0x0c/AmbientPixel/Docs/markdown/FutureWork.md

# Future works

## パケット仕様の拡張
より高度な制御を行うために、パケットの仕様を拡張する。
以下、策定中のパケット仕様。

--

### パケットのデータ構造
#### 基本構造
BaseパケットとDataパケットに大別される。

#### Baseパケット

````
Base packet
|---3bit---|----5bit----|
|---type---|--data len--|
````

- type
	- パケットの種類
		- echo → 000
		- pattern → 001
		- data → 011
		- int → 100
		- int_cast → 101
		- run → 110
		- reset → 111
		- 記載していないビットは予約
- data len
	- データ長(バイト)
		- 1〜32バイト
		- 後続にデータ長*2個だけパケットが続く

#### Dataパケット

````
Data packet
|---3bit---|---4bit---|---1bit---|
|---type---|---data---|--parity--|
````

- type
	- 011
- data
	- データ部
- parity
	- パリティビット(奇数パリティ)

### echoパケット
**Base部**

- type
	- 000
- data len
	- 2
	
**Data部**

````
|---8bit---|
|----to----|
~
|---8bit---|
|---from---|
````

- to
	- 送信先デバイスID
		- masterへの場合は0
		- それ以外はフルビット
- from
	- 送信元デバイスID
		- masterからの場合は0
	
**解説**

echoパケットを受信したらmasterへ向けて返答する。
また、echoパケットを別ポートからフォワードする。

### patternパケット
**Base部**

- type
	- 001
- data len
	- 2〜32
	
**Data部**

````
|---8bit---|
|----to----|
~
|---8bit---|
|--pattern-|
~
...
````

**解説**

### intパケット
**Base部**

- type
	- 100
- data len
	- 0

**Data部**

なし

**解説**

intパケットを受け取ったノードはインタラクティブ状態へ遷移する。

### int_castパケット
**Base部**

- type
	- 101
- data len
	- 0

**Data部**

なし

**解説**

int_castパケットを受け取ったノードはインタラクティブ状態へ遷移する。
また、int_castパケットを別ポートからフォワードする。

### runパケット
**Base部**

- type
	- 110
- data len
	- 0

**Data部**

なし

**解説**

runパケットを受け取ったノードは実行状態へ遷移する。
また、runパケットを別ポートからフォワードする。

### resetパケット
**Base部**

- type
	- 111
- data len
	- 0

**Data部**

なし

**解説**

resetパケットを受け取ったノードは待機状態へ遷移する。
また、resetパケットを別ポートからフォワードする。

### 伝搬アルゴリズム
#### echoパケットによるマップツリー生成
Masterの各辺に対する2分木が作れる気がする。

#### パターンデータ伝搬
patternパケットで伝搬する

#### 指定ノードへのデータ送信
前述で生成したマップツリーから、パケットのdestに応じてforwardする。

## Software
### 状態
- 待機状態（Waiting）
	- データの受信待ち
- 受信状態（Receiving）
	- データを受信中。
	- Waiting状態時にpatternパケットを受け取った時に遷移する。
	- 待機状態中に受け取った最初のパケットから、データ長回だけ受信を行う。
	- 受信し終わったらWaitingへ遷移する。
- 実行状態（Running）
	- ストアに保持しているパターンを順次実行
	- runパケットを受け取った時に遷移する。
- インタラクティブ（Interactive）
	- 受け取ったパターンを即時実行



### パターン再生ロジック
#### パターンストアへパターンを登録
パターンパケットを受信した順番でパターンストア（配列）に格納する。
runパケットを受信すると順次パターンを実行する。
resetパケットを受信するとストアはクリアされる。

#### パターンストアを順次実行
パターンにしたがってLEDを点灯させる。

#### プリセットパターン
