0x0c/AmbientPixel/Asset/Image/DSC04133.jpg

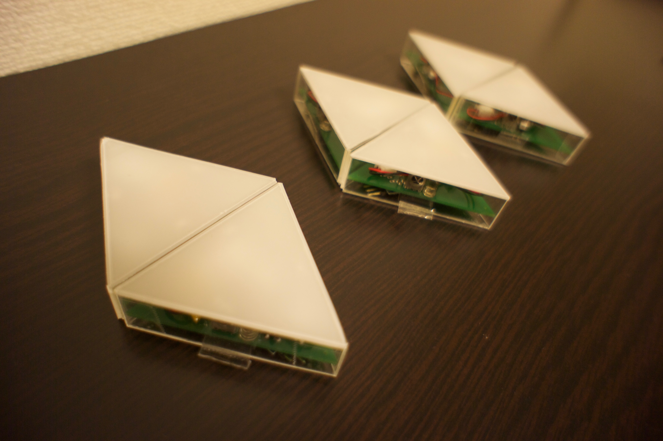
Asset/Image/DSC04133.jpg
