0x0c/AmbientPixel/Asset/Image/DSC04134.jpg

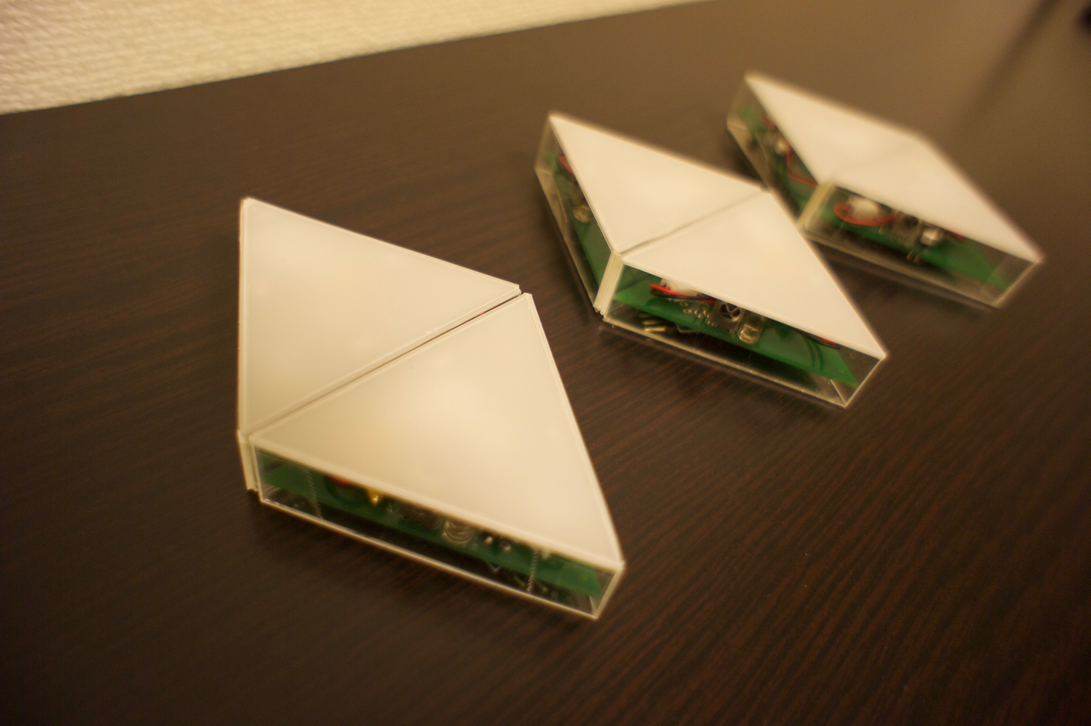
Asset/Image/DSC04134.jpg
