0x0c/AmbientPixel/Asset/Image/DSC04135.jpg

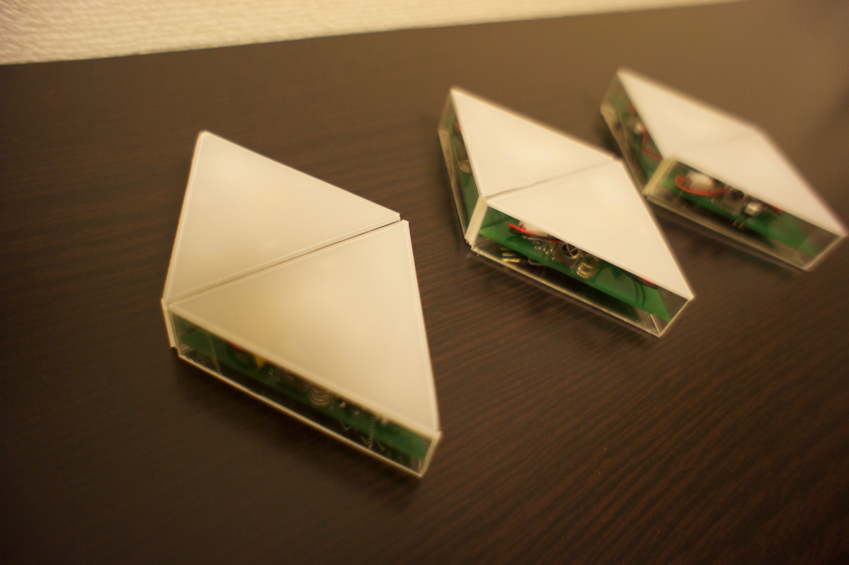
Asset/Image/DSC04135.jpg
