0x0c/AmbientPixel/Asset/Image/DSC04136.jpg

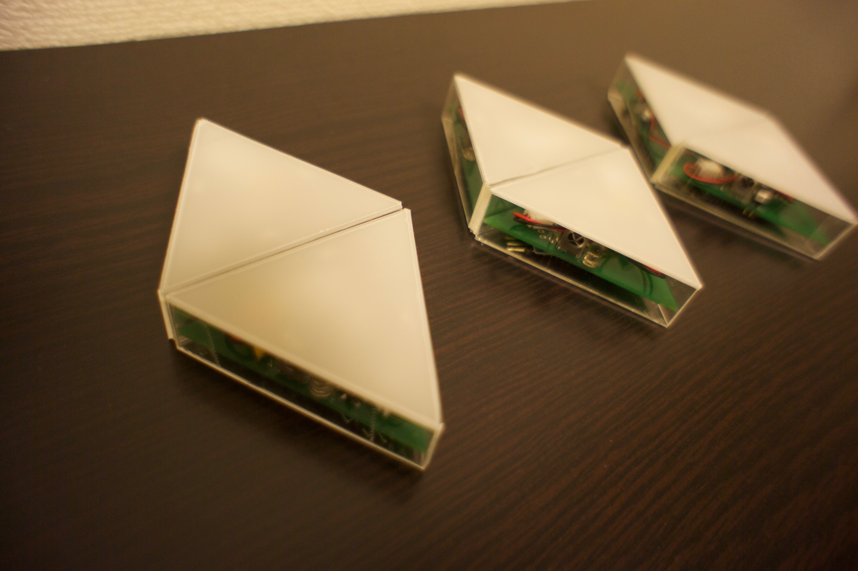
Asset/Image/DSC04136.jpg
