0x0c/AmbientPixel/Asset/Image/DSC04138.jpg

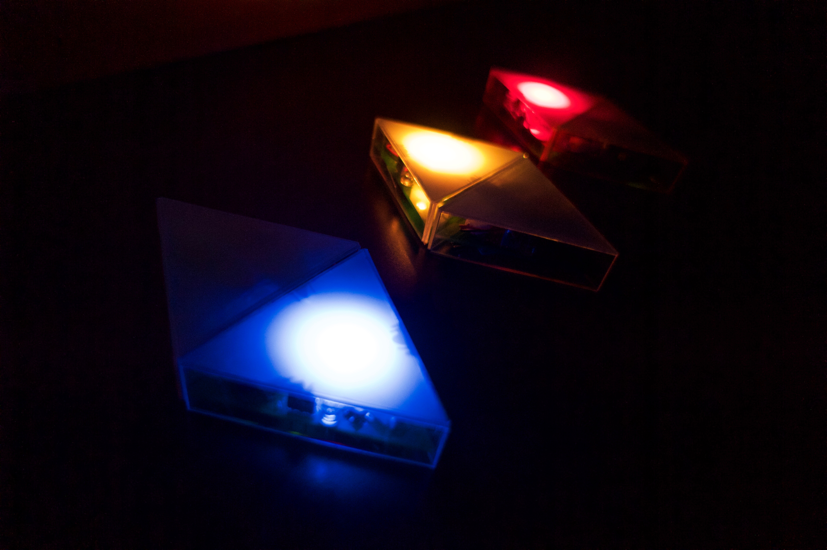
Asset/Image/DSC04138.jpg
