0x0c/AmbientPixel/Asset/Image/DSC04139.jpg

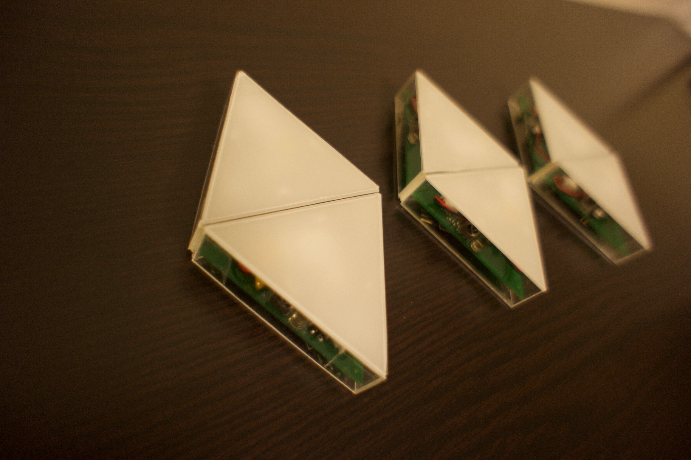
Asset/Image/DSC04139.jpg
