0x0c/AmbientPixel/Asset/Image/DSC04140.jpg

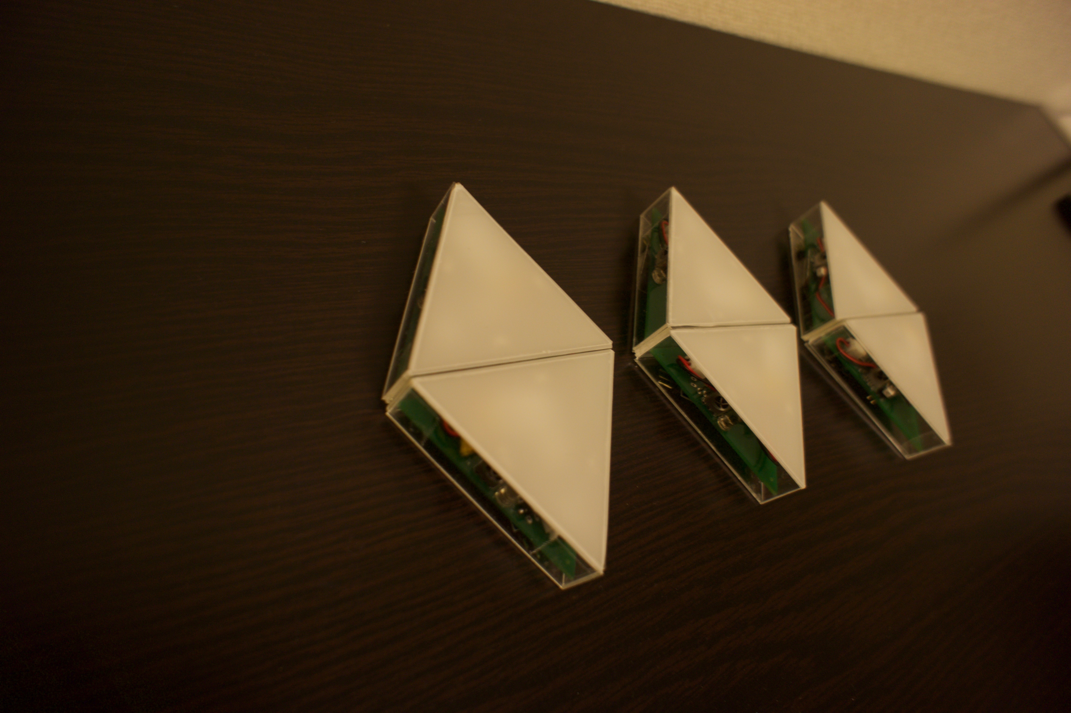
Asset/Image/DSC04140.jpg
