0x0c/AmbientPixel/Asset/Image/DSC04141.jpg

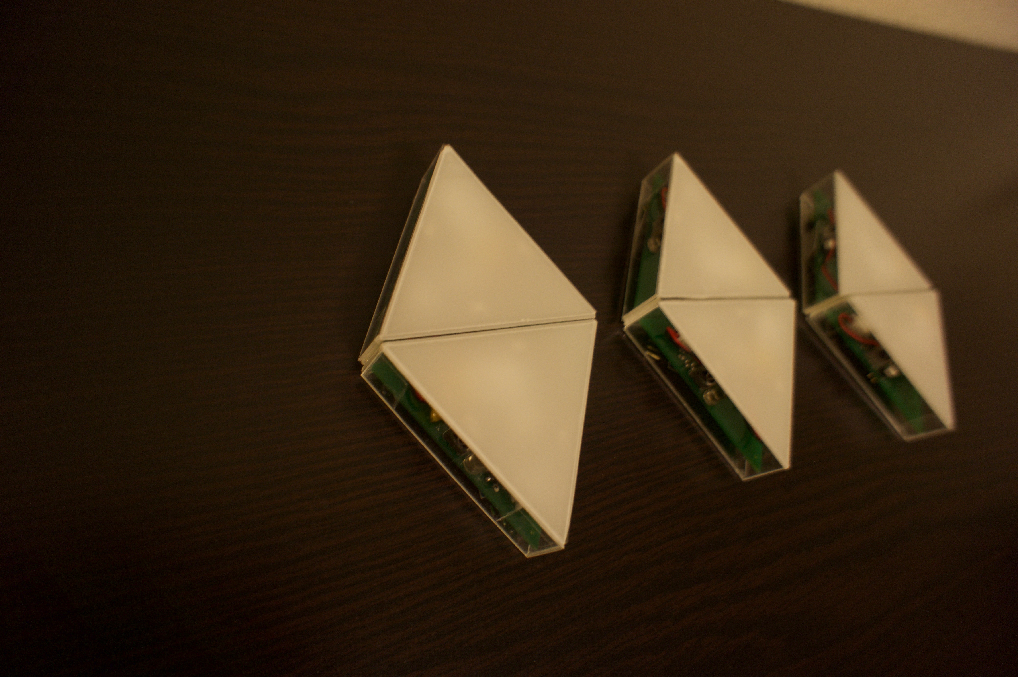
Asset/Image/DSC04141.jpg
