0x0c/AmbientPixel/Asset/Image/DSC04142.jpg

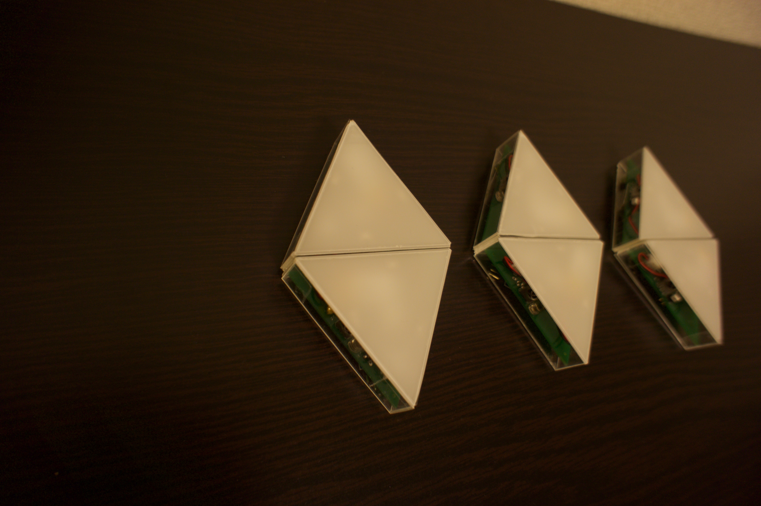
Asset/Image/DSC04142.jpg
