0x0c/AmbientPixel/Asset/Image/DSC04143.jpg

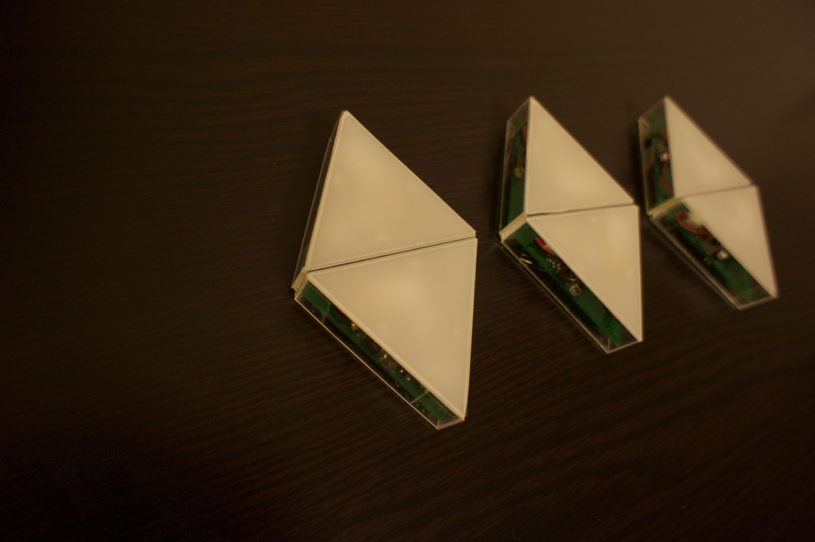
Asset/Image/DSC04143.jpg
