0x0c/AmbientPixel/Asset/Image/DSC04144.jpg

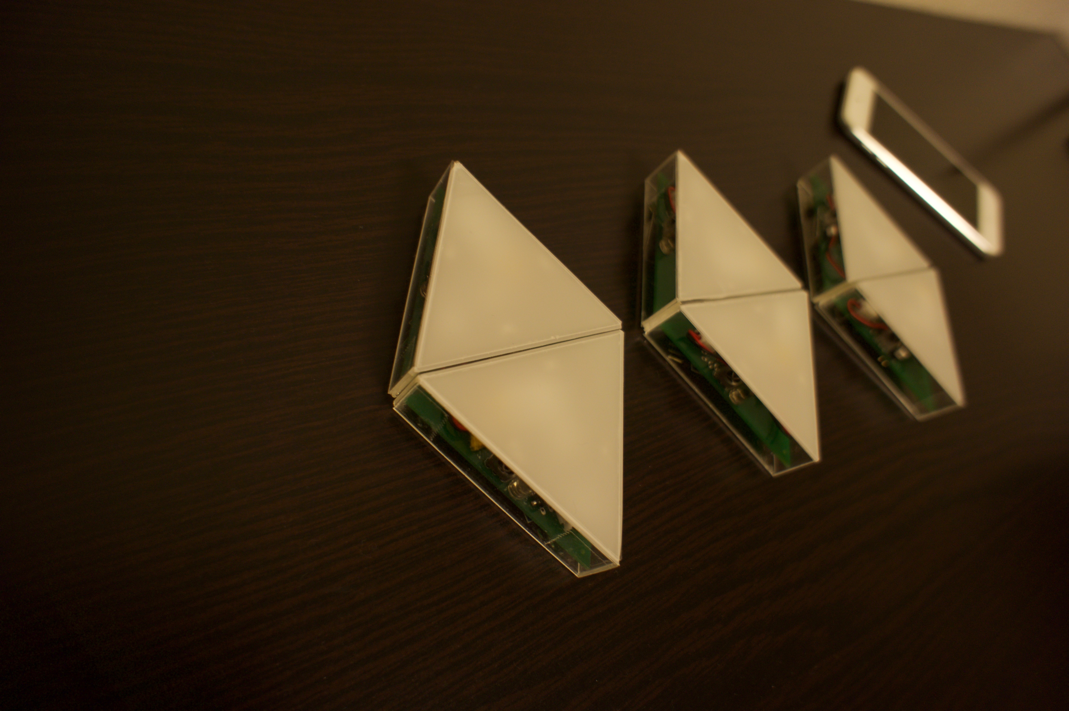
Asset/Image/DSC04144.jpg
