0x0c/AmbientPixel/Asset/Image/DSC04145.jpg

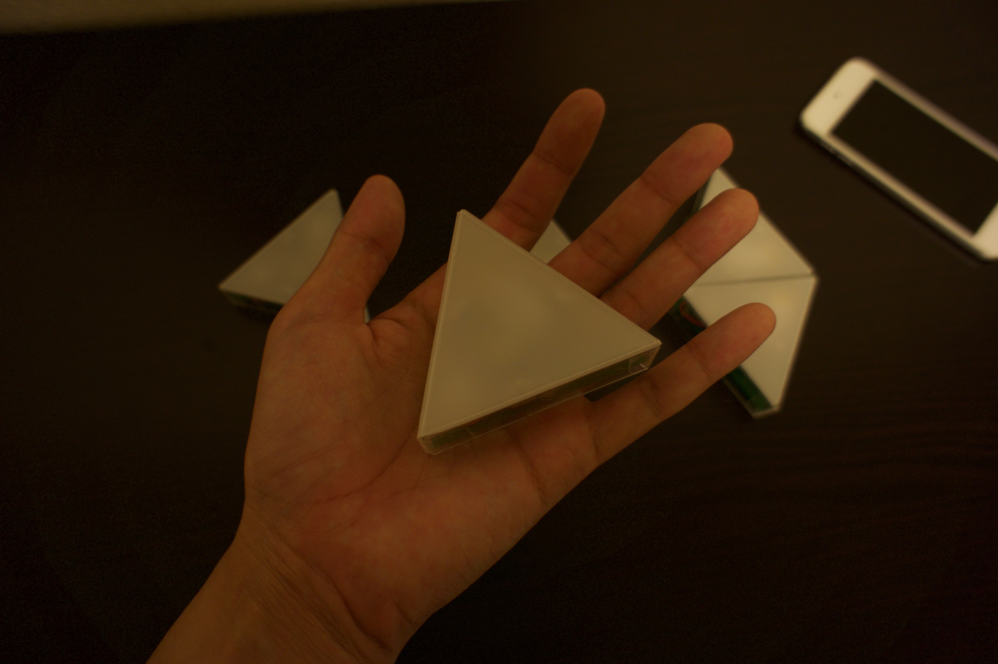
Asset/Image/DSC04145.jpg
