0x0c/AmbientPixel/Asset/Image/DSC04146.jpg

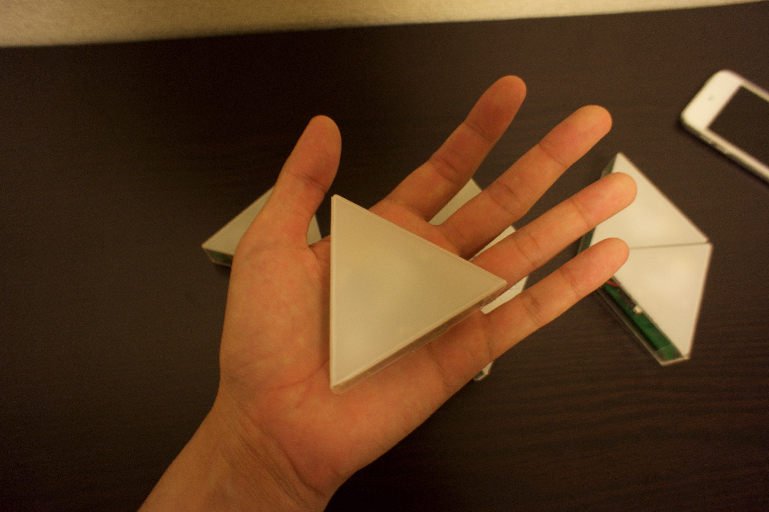
Asset/Image/DSC04146.jpg
