0x0c/AmbientPixel/Asset/Image/IMG_3755.JPG

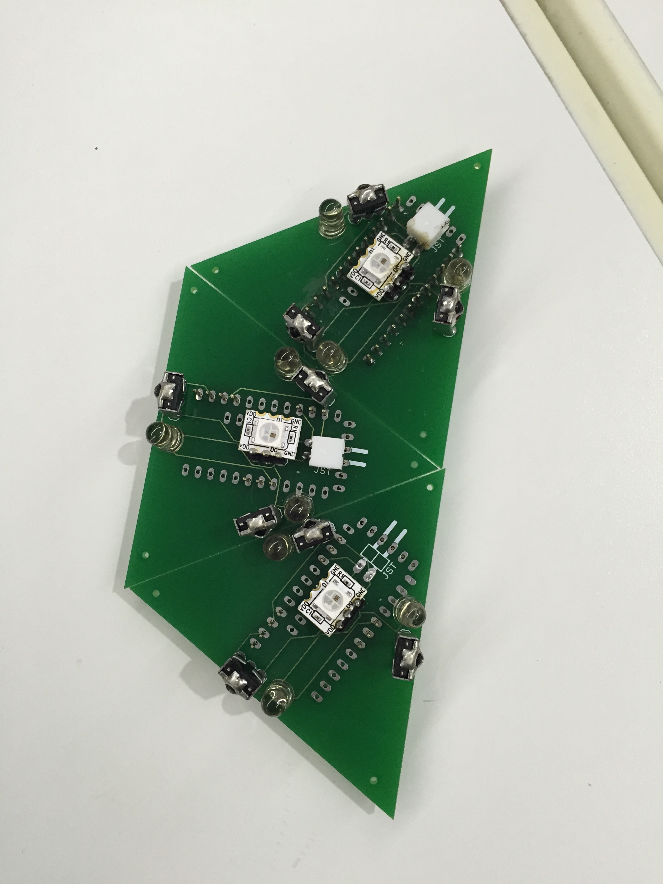
Asset/Image/IMG_3755.JPG
