0x0c/AmbientPixel/Asset/Image/IMG_3774.JPG

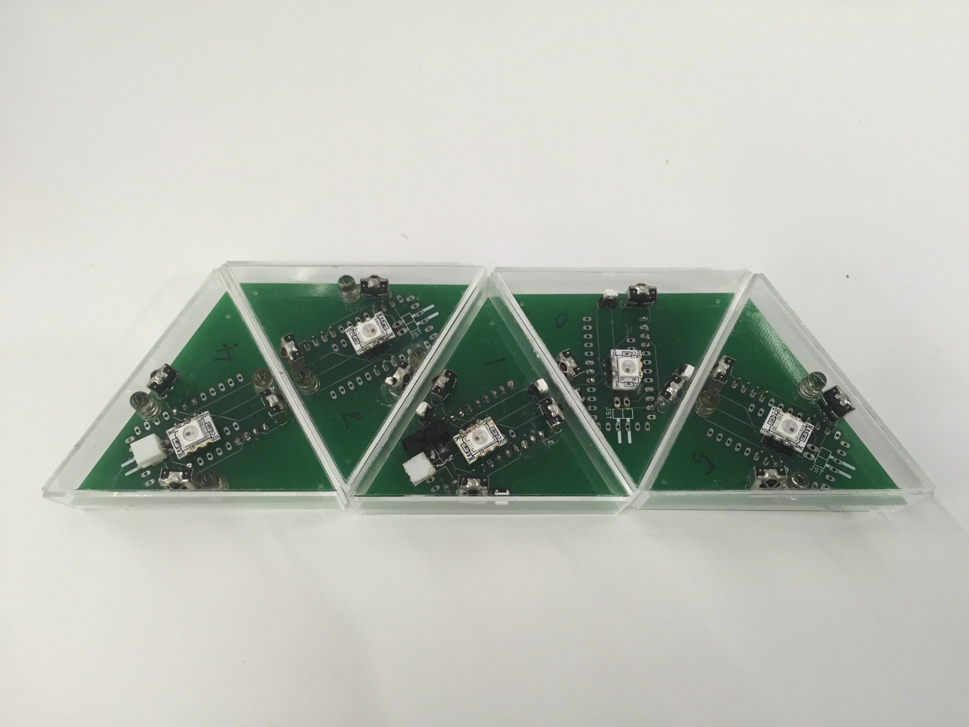
Asset/Image/IMG_3774.JPG
