0x0c/AmbientPixel/Asset/Image/IMG_3775.JPG

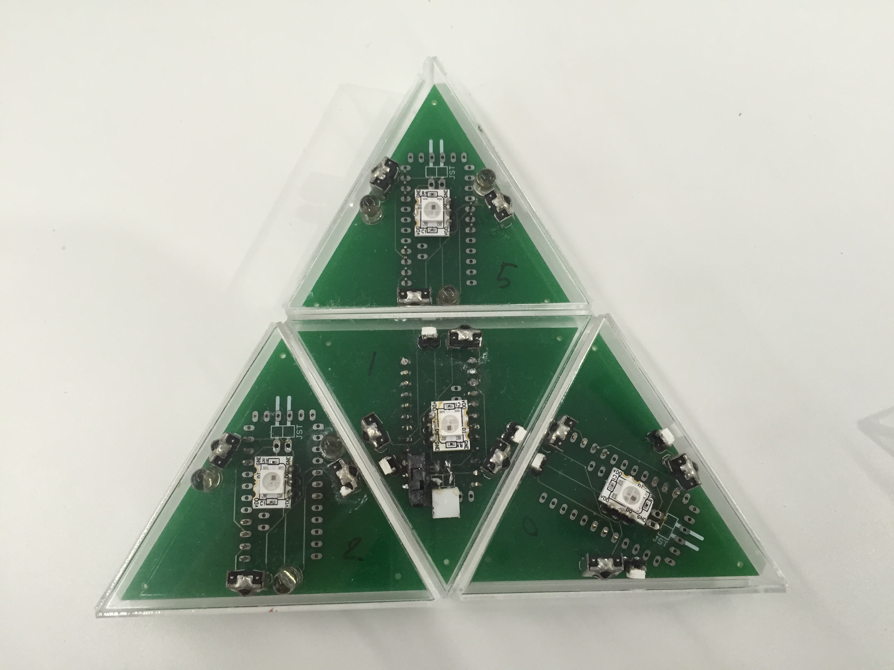
Asset/Image/IMG_3775.JPG
