0x0c/AmbientPixel/Asset/Image/IMG_3776.JPG

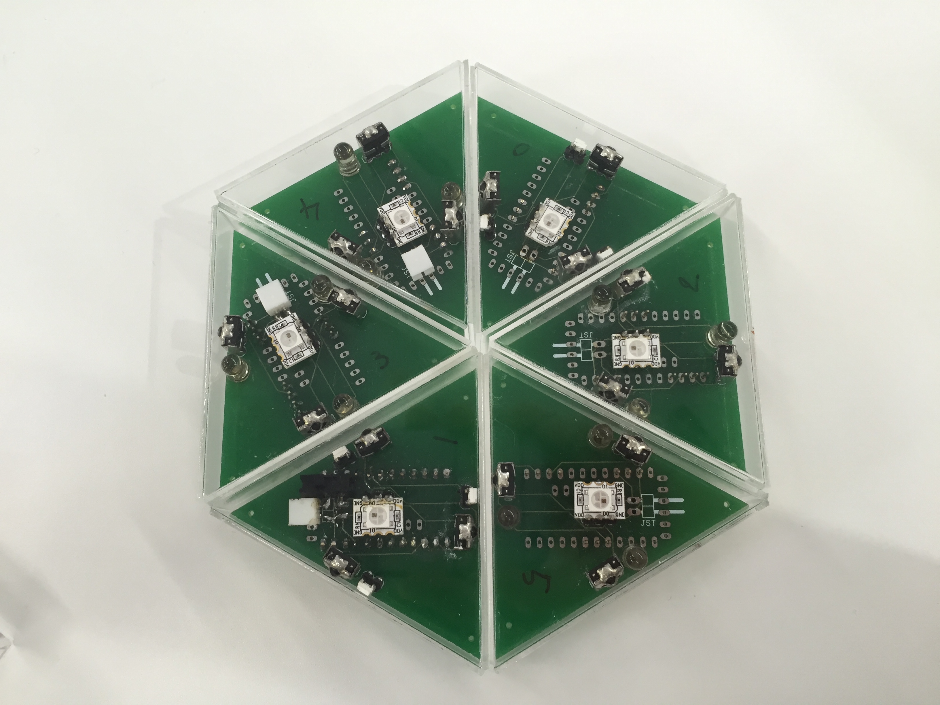
Asset/Image/IMG_3776.JPG
