0x0c/AmbientPixel/Asset/Image/IMG_3777.JPG

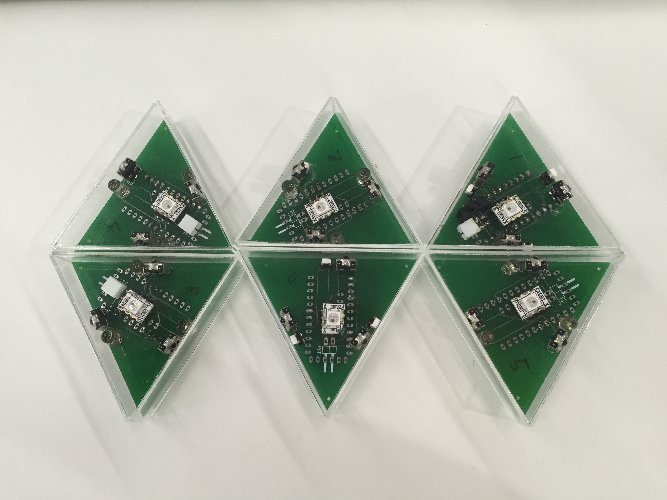
Asset/Image/IMG_3777.JPG
