0x0c/AmbientPixel/Asset/Image/IMG_3778.JPG

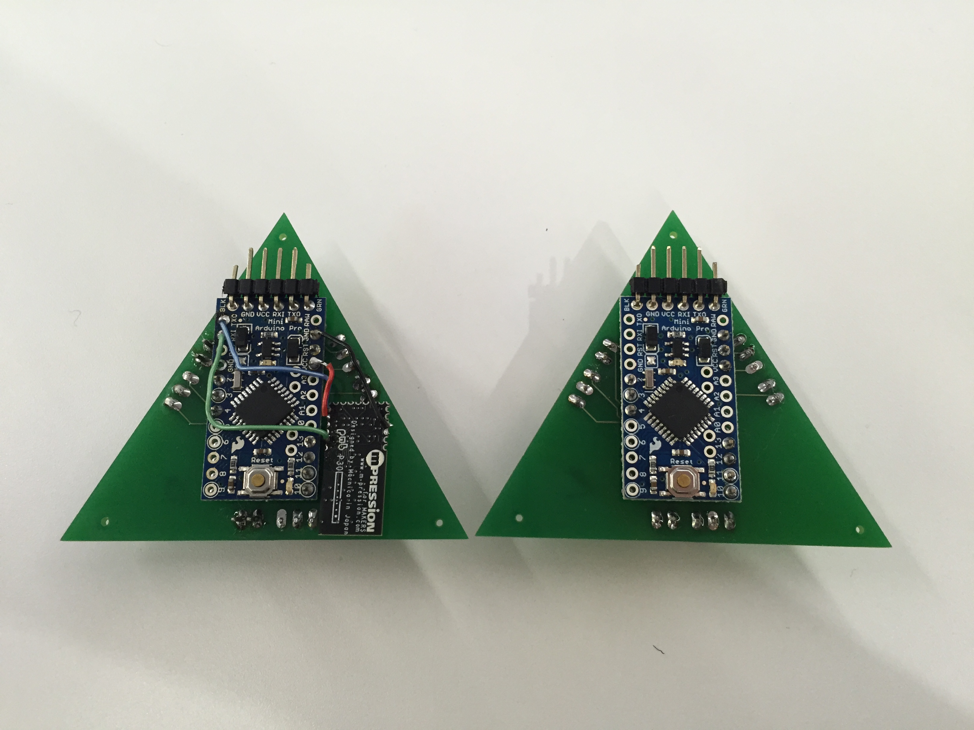
Asset/Image/IMG_3778.JPG
