0x0c/AmbientPixel/Asset/Image/IMG_3779.JPG

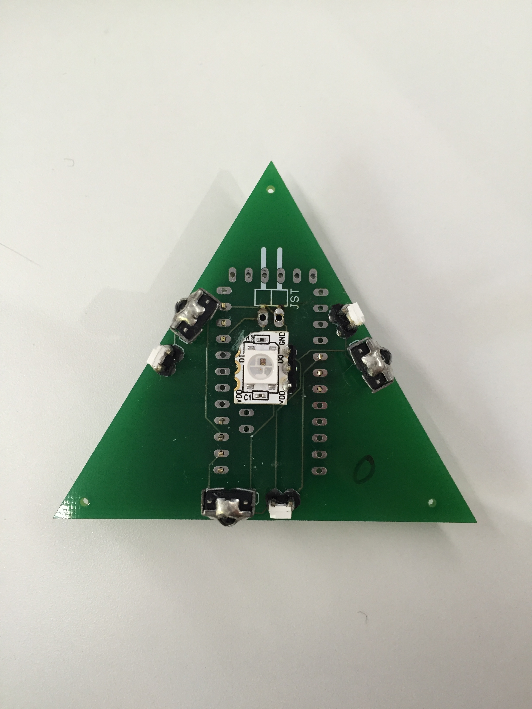
Asset/Image/IMG_3779.JPG
