0x0c/AmbientPixel/Asset/Image/p1-1.jpg

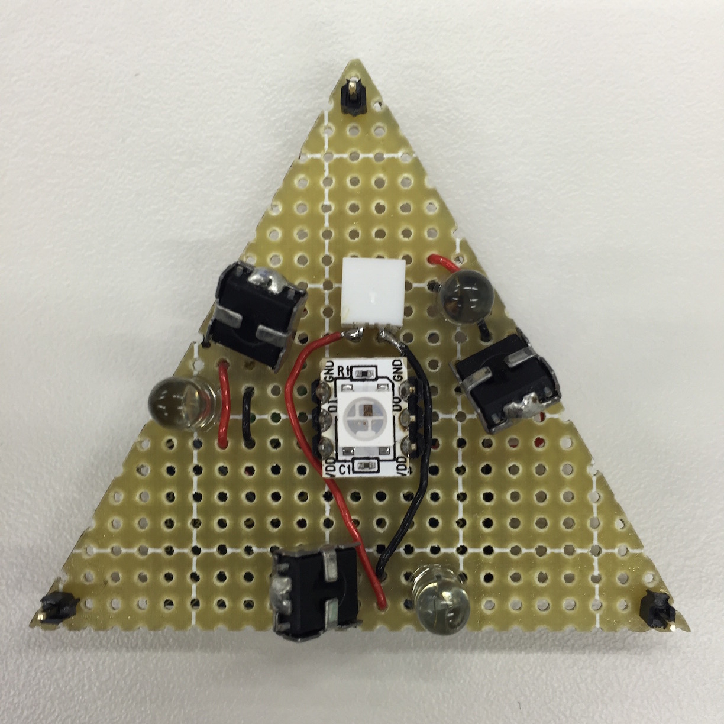
Asset/Image/p1-1.jpg
