0x0c/AmbientPixel/Asset/Image/p1-2.jpg

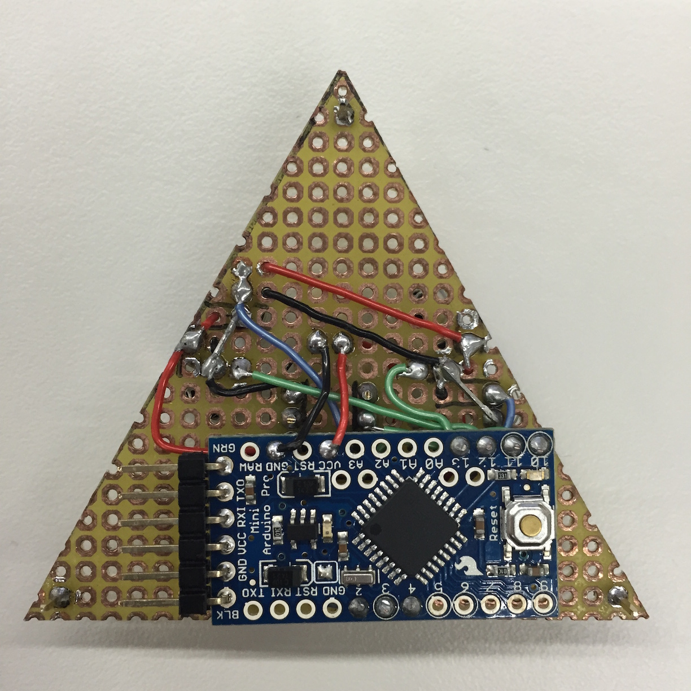
Asset/Image/p1-2.jpg
