0x0c/AmbientPixel/Docs/markdown/usecase_picture.PNG

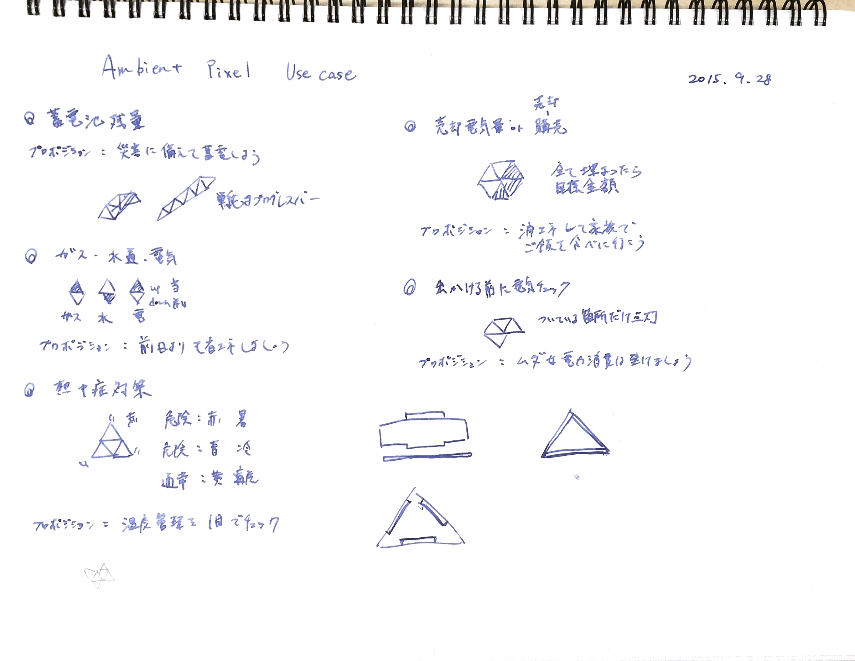
Docs/markdown/usecase_picture.PNG
