0x0c/AmbientPixel/Design/PatternMaker/View Copy 2.png

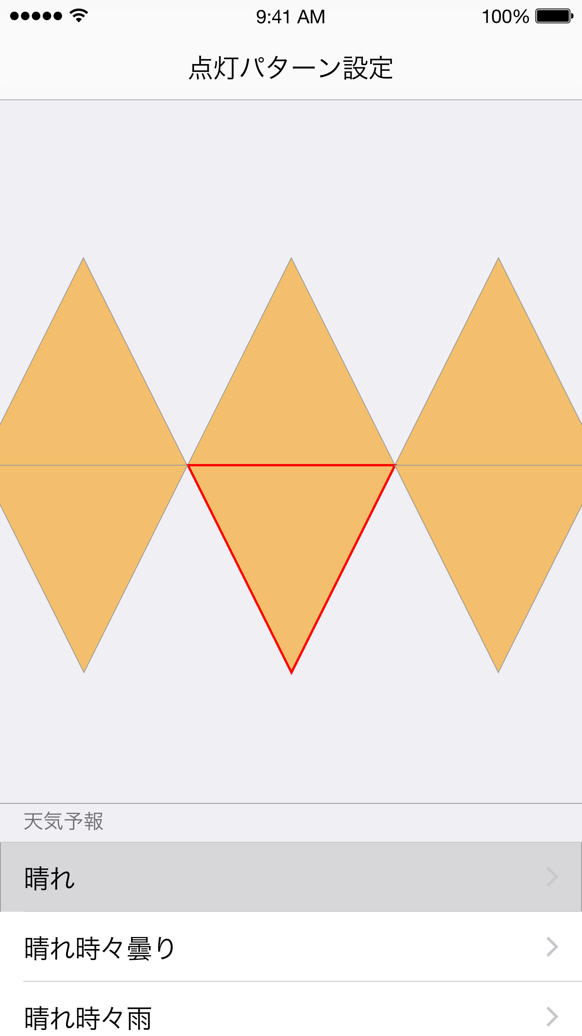
Design/PatternMaker/View Copy 2.png
