0x0c/AmbientPixel/Design/PatternMaker/View Copy.png

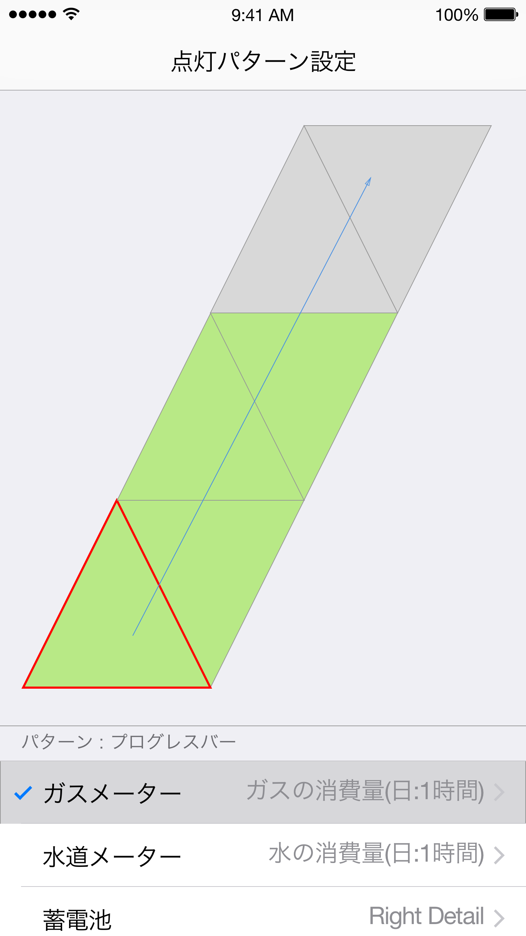
Design/PatternMaker/View Copy.png
