0x0c/AmbientPixel/Design/PatternMaker/View.png

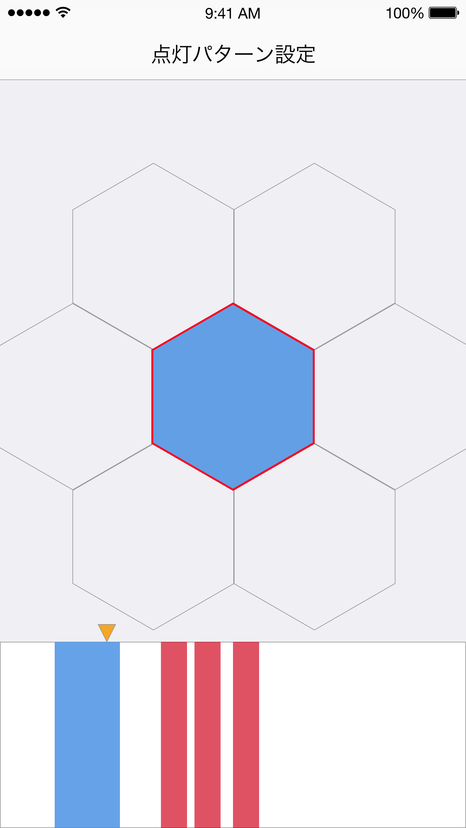
Design/PatternMaker/View.png
