0x0c/AmbientPixel/Hardware/AmbientPixel/MainBoard.brd

## EAGLE design Hardware/AmbientPixel/MainBoard.brd (2015-08-21)

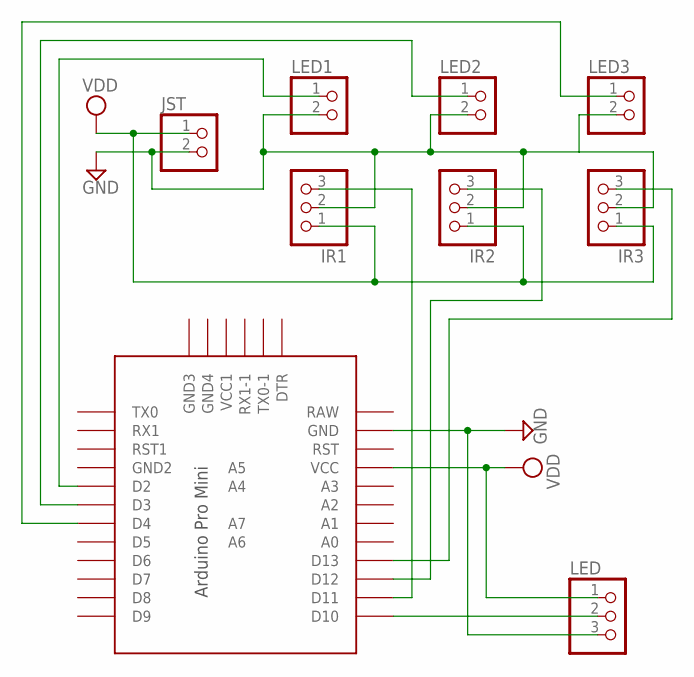
[picture p28: schematic MainBoard.sch]

Parts:
IR1, IR2, IR3: PINHD-1X3; 1X03
JST: PINHD-1X2/90; 1X02/90
LED: PINHD-1X3; 1X03
LED1, LED2, LED3: PINHD-1X2; 1X02
U$1: PRO-MINI-2

Connections:
GND: IR1.2, IR2.2, IR3.2, JST.2, LED.3, LED1.2, LED2.2, LED3.2, U$1.GND
unnamed: LED.2, U$1.D10
unnamed: LED1.1, U$1.D2
unnamed: LED2.1, U$1.D3
unnamed: LED3.1, U$1.D4
unnamed: IR1.3, U$1.D11
unnamed: IR2.3, U$1.D12
unnamed: IR3.3, U$1.D13
VDD: IR1.1, IR2.1, IR3.1, JST.1, LED.1, U$1.VCC

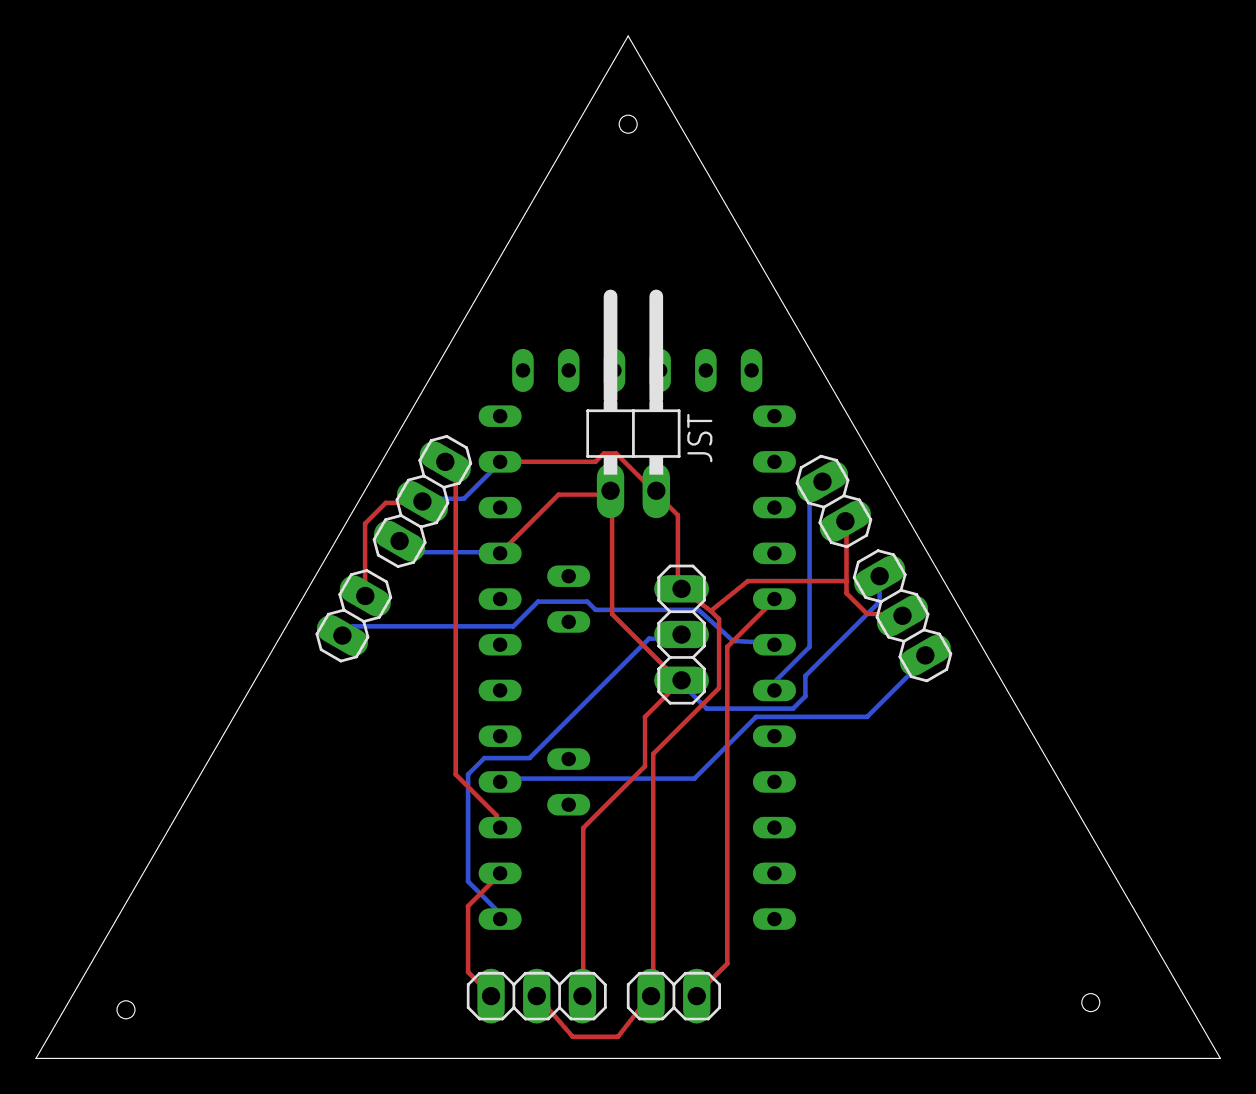
[picture p29: board MainBoard.brd from above]

Board: 2 copper layers, 65.8 x 56.8 mm, 9 parts (1 on the bottom side), 9 nets.
