0x0c/AmbientPixel/(commit log)

2015-08-06 fix for Arduino1.6.5
2015-08-19 テストプロジェクトの追加
2015-08-19 コメントなど追加
2015-08-21 add eagle project
    [MainBoard.brd, MainBoard.sch]
2015-08-21 スケジュールの追加
2015-08-21 p板に納品したファイルの追加
    [MainBoard.brd, 製造指示書.xls]
2015-08-23 パターンについて月
2015-08-24 コメント追記
2015-08-24 Portクラスを追加してみた
2015-08-25 グラデーションのテストプロジェクトの追加
2015-08-27 色メソッドの実装switch
2015-08-27 色メソッドの実装7色switch
2015-08-28 7色実装
2015-08-28 サンプルの修正
2015-08-28 色変更メソッドの追加
2015-08-28 コンパイルエラーの修正
2015-08-30 いろいろ
2015-08-30 namespaceの追加
2015-08-30 メソッド名の規則の修正
2015-09-12 サンプルプロジェクトの修正
2015-09-12 podfileの追加
2015-09-12 サンプルプロジェクトの追加
2015-09-14 仕様書のfix
2015-09-19 新しい仕様に追従
2015-09-20 ファイルの追加
2015-09-20 フラグの変更
2015-09-20 fix API and firmware
    [AmbientPixel.h, firmware.ino]
2015-09-20 print log in simulator
2015-09-20 Packetにdumpメソッドを追加
2015-09-20 ファームウェアの実装
2015-09-23 設定画面の実装
2015-09-23 定数の並び順の変更
2015-09-24 ファームウェアの更新
2015-09-24 パケットの仕様変更に伴うPortクラスの追加。
2015-09-27 シミュレータにAccept処理の実装
2015-09-27 シミュレータの実装
2015-09-27 コメントの追加
2015-09-27 表示の修正
2015-09-27 逆引きメソッドの追加
2015-09-27 パケットに応じた処理の実装
2015-09-27 リセットパケットの実装
2015-09-28 実験用プロジェクトの追加
2015-09-28 通信機能の実装
2015-09-28 相互通信の実装
2015-09-28 フラグに応じてLEDの点灯させる
2015-09-29 ユースケース追加
2015-09-29 写真追加
2015-10-12 ブロードキャスト版
2015-10-12 非表示からグローして立ち上がる
2015-10-12 色取得メソッドのバグ修正
2015-10-12 Yellowの削除
2015-10-12 フォワード消去
2015-10-12 マスターのfirmware(テスト用)
